eSqadron/Vibrometer-Positioning-Table/MEng text/img/6_GraphThird.jpg

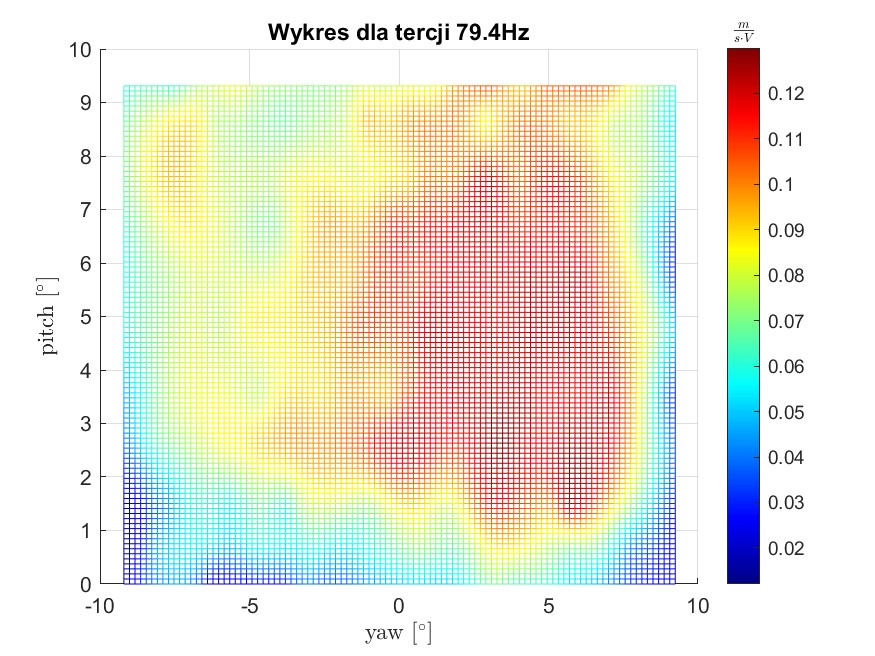
MEng text/img/6_GraphThird.jpg
