eSqadron/Vibrometer-Positioning-Table/MEng text/img/7_GraphThird.jpg

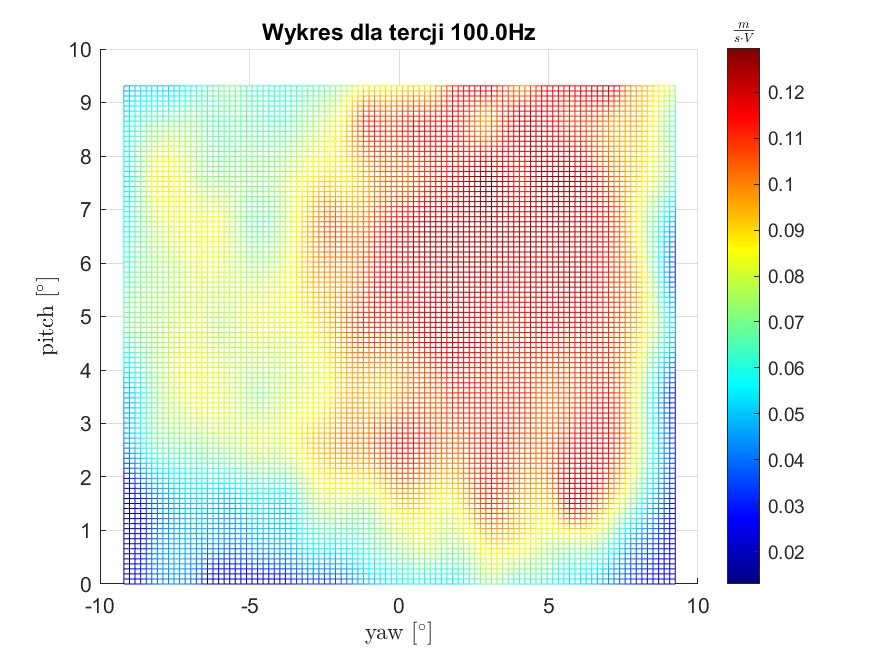
MEng text/img/7_GraphThird.jpg
