eSqadron/Vibrometer-Positioning-Table/MEng text/img/10_GraphThird.jpg

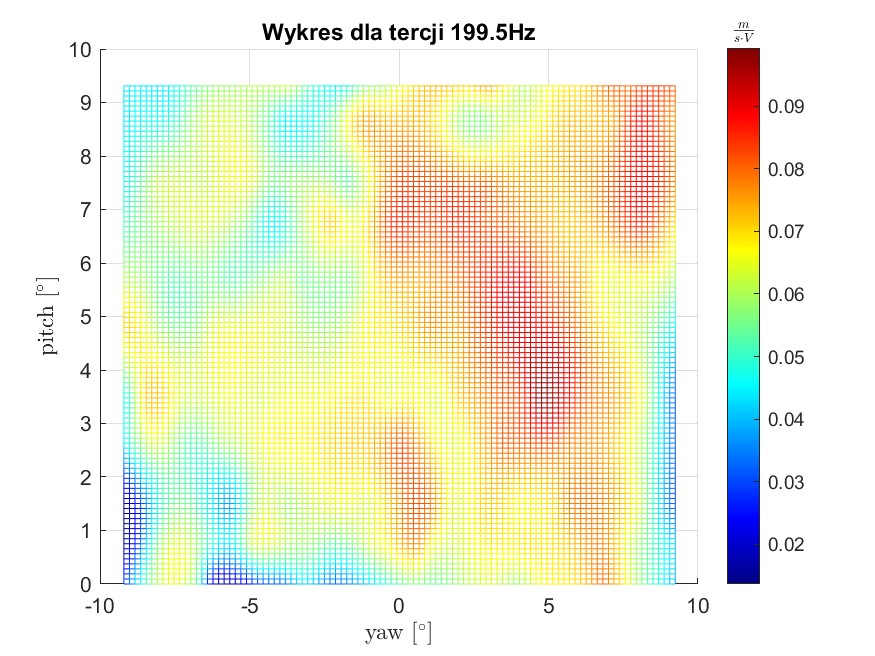
MEng text/img/10_GraphThird.jpg
