eSqadron/Vibrometer-Positioning-Table/MEng text/img/11_GraphThird.jpg

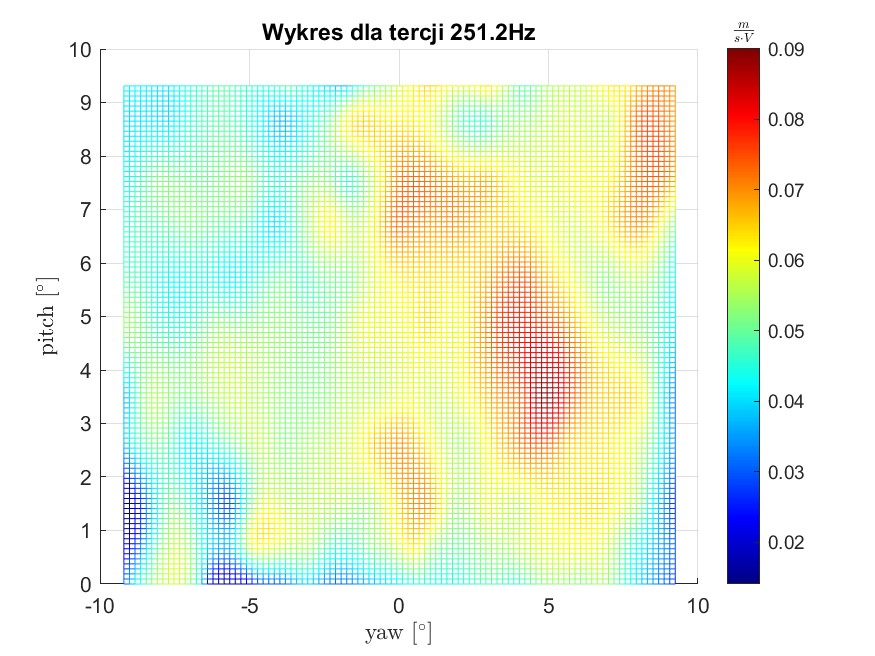
MEng text/img/11_GraphThird.jpg
