eSqadron/Vibrometer-Positioning-Table/MEng text/img/13_GraphThird.jpg

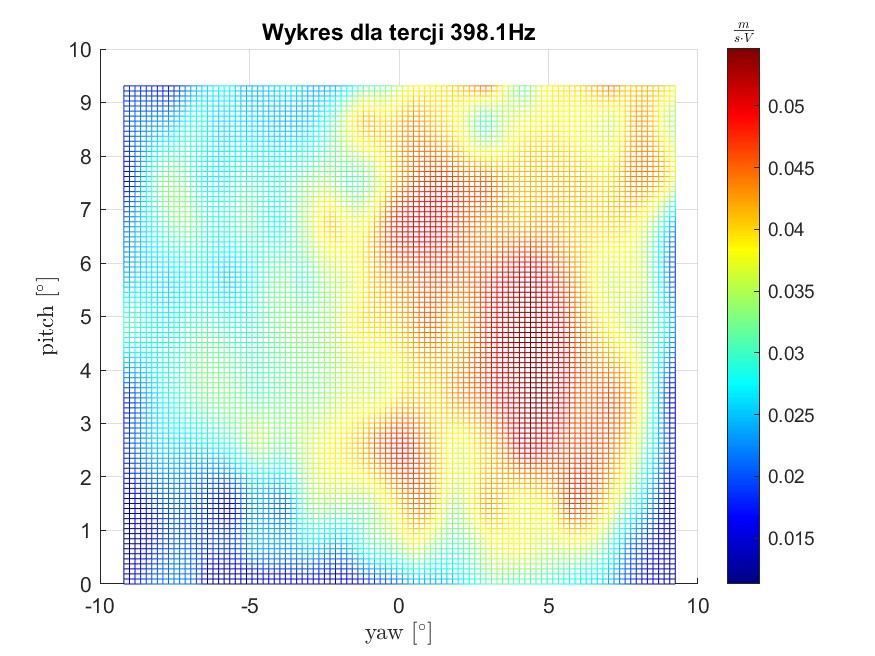
MEng text/img/13_GraphThird.jpg
