eSqadron/Vibrometer-Positioning-Table/MEng text/img/16_GraphThird.jpg

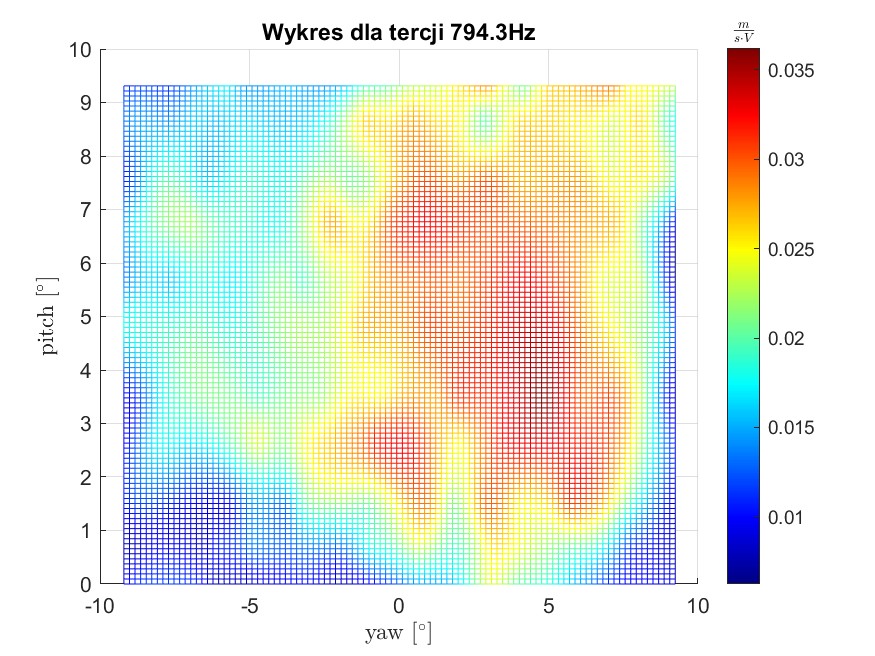
MEng text/img/16_GraphThird.jpg
