eSqadron/Vibrometer-Positioning-Table/MEng text/img/17_GraphThird.jpg

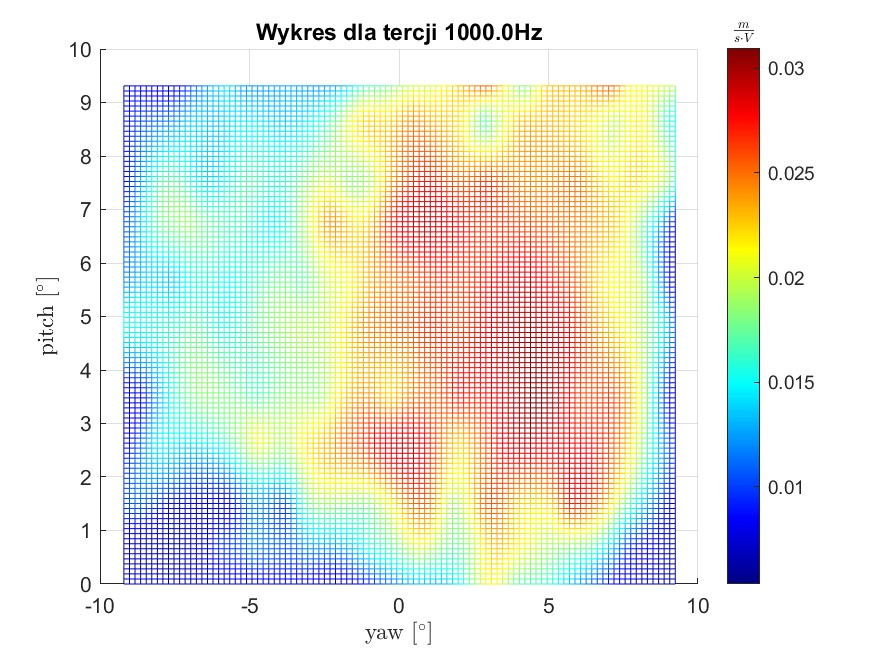
MEng text/img/17_GraphThird.jpg
