eSqadron/Vibrometer-Positioning-Table/MEng text/img/PCB.png

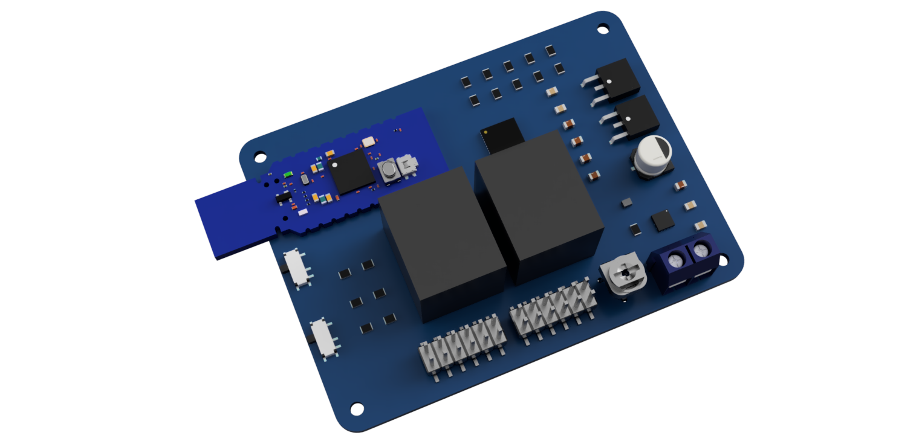
MEng text/img/PCB.png
