eSqadron/Vibrometer-Positioning-Table/MEng text/img/wib_meas.jpg

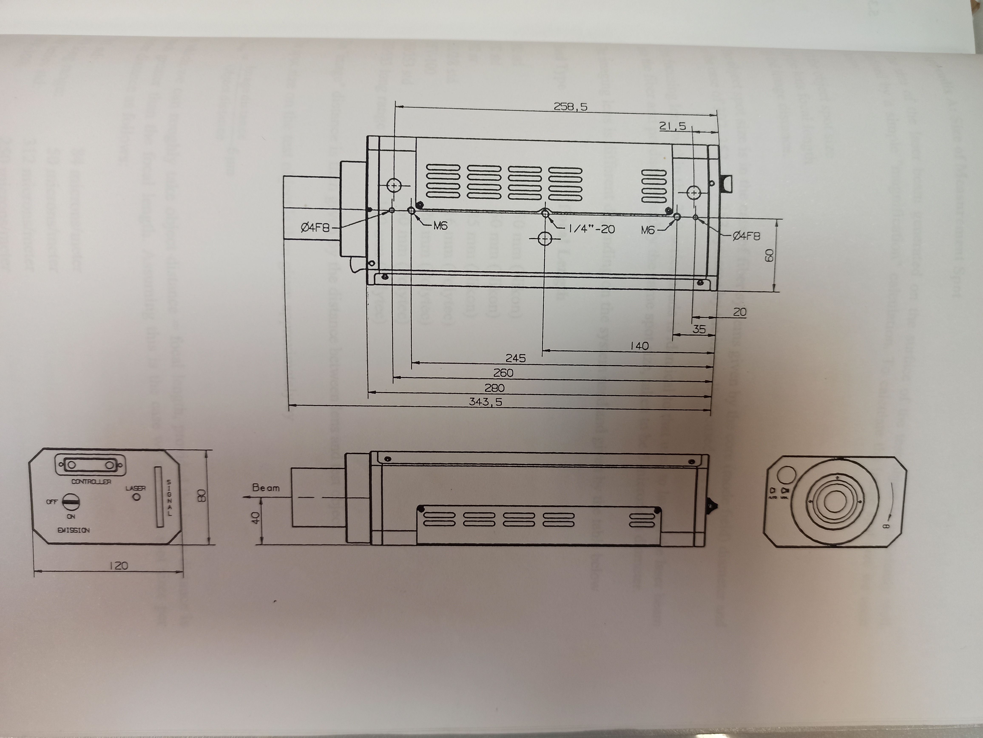
MEng text/img/wib_meas.jpg
