eSqadron/Vibrometer-Positioning-Table/(list of files, cad)

Other CAD files:
3D_Designs/Base Spacer v8.f3d
3D_Designs/Down Table v5.f3d
3D_Designs/Holder1 v12.f3z
3D_Designs/Holder2 v12.f3z
3D_Designs/HolderBase v18.f3d
3D_Designs/HubSpacer2 v3.f3d
3D_Designs/HubSpacer5 v2.f3d
3D_Designs/PartialMovementTable v18.f3d
3D_Designs/StaticBase v19.f3d
3D_Designs/VibrometerPositioningTable v34.f3z
3D_Designs/plywood_plate v12.f3d
