eSqadron/Vibrometer-Positioning-Table/MEng text/img/MeasSetup.png

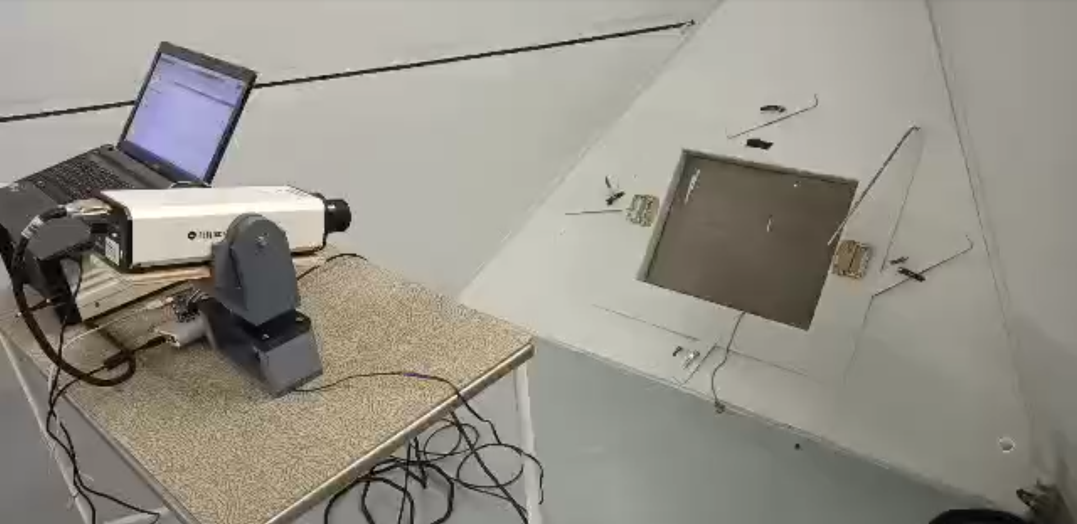
MEng text/img/MeasSetup.png
