eSqadron/Vibrometer-Positioning-Table/src_Firmware/src/scan_adc.c

// SPDX-License-Identifier: Apache-2.0
// Copyright (c) 2024 Jakub Mazur
#if defined(CONFIG_AUTO_MEASUREMENTS)

#include <zephyr/drivers/adc.h>
#include "scan_adc.h"


static const struct adc_dt_spec adc_channel = ADC_DT_SPEC_GET(DT_PATH(zephyr_user));

static bool is_initialised; // False by default

int16_t buf;
struct adc_sequence sequence = {
	.buffer = &buf,
	/* buffer size in bytes, not number of samples */
	.buffer_size = sizeof(buf),
	//Optional
	//.calibrate = true,
};

void init_adc_scan(void)
{
	__ASSERT(adc_is_ready_dt(&adc_channel),
		"ADC controller devivce %s not ready", adc_channel.dev->namel);

	__ASSERT_EVAL((void) adc_channel_setup_dt(&adc_channel),
		int r = adc_channel_setup_dt(&adc_channel),
		r < 0, "Could not setup channel #%d (%d)", 0, r);

	__ASSERT_EVAL((void) adc_sequence_init_dt(&adc_channel, &sequence),
		int r = adc_sequence_init_dt(&adc_channel, &sequence),
		r < 0, "Could not initialize sequnce");

	is_initialised = true;
}

scan_return_codes_t perform_meas(int *out_val)
{
	int err;

	if (!is_initialised) {
		return ADC_NOT_INITIALISED;
	}

	err = adc_read(adc_channel.dev, &sequence);
	if (err < 0) {
		return ADC_READ_FAIL;
	}

	*out_val = buf;

	err = adc_raw_to_millivolts_dt(&adc_channel, out_val);

	/* conversion to mV may not be supported, skip if not */
	if (err < 0) {
		return ADC_CONVERSION_FAIL;
	}

	return SCAN_SUCCESS;
}
#endif
