eSqadron/Vibrometer-Positioning-Table/(commit log)

2024-05-31 API for driver scanner working
2024-05-31 ADC API working
2024-05-31 1. reseting status at dump 2. check if scaner is fully defined 3. precision increase
    [scan_driver.c, scan_driver.h, scan_uart.c]
2024-05-31 Motor controller commit change
2024-05-31 Fixes: 1. timer not needed for manual 2. scan dump always cleares Finished status
    [scan_uart.c]
2024-05-31 is_target_achieved moved to main driver
2024-05-31 Possibly good regulator parameters
2024-05-31 motor controller firmware update
2024-08-05 Archiving 3D designs
    [Base Spacer v8.f3d, Down Table v5.f3d, Holder1 v12.f3z, Holder2 v12.f3z, HolderBase v18.f3d, HubSpacer2 v3.f3d, HubSpacer5 v2.f3d, PartialMovementTable v18.f3d]
